adiace/sesame-robot-sense/hardware/printing/stl/Internal-Frame-v121.stl

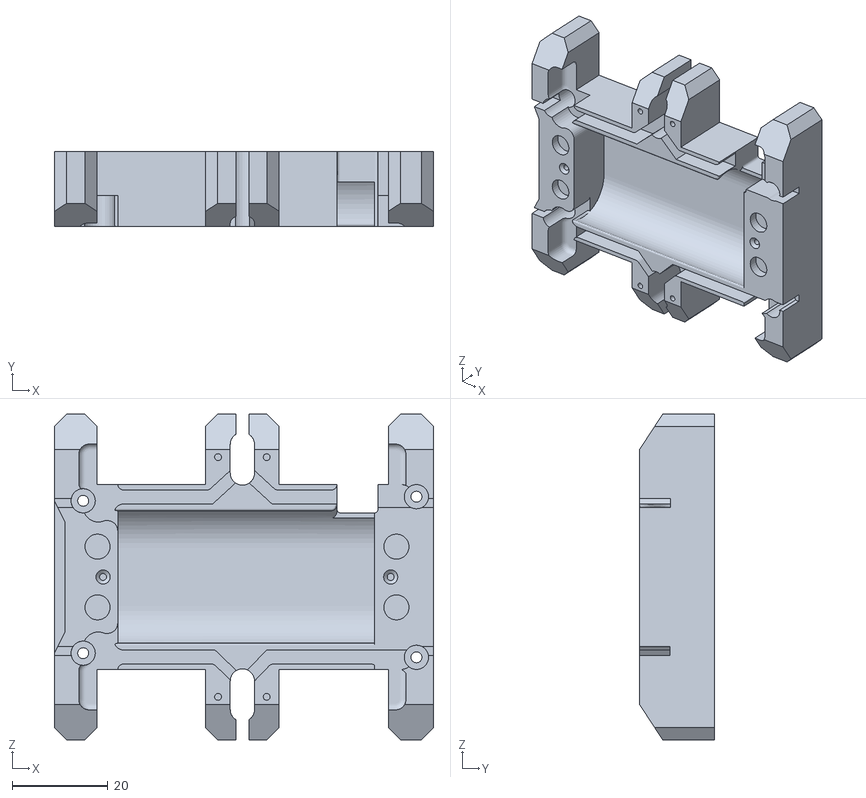
[picture p1: CAD file, 2026-05-30, last stored version]
hardware/printing/stl/Internal-Frame-v121.stl
79.2 x 15.7 x 68.1
