adiace/sesame-robot-sense/hardware/printing/stl/top-covers/hats/magnetic-modular-mount-hat.stl

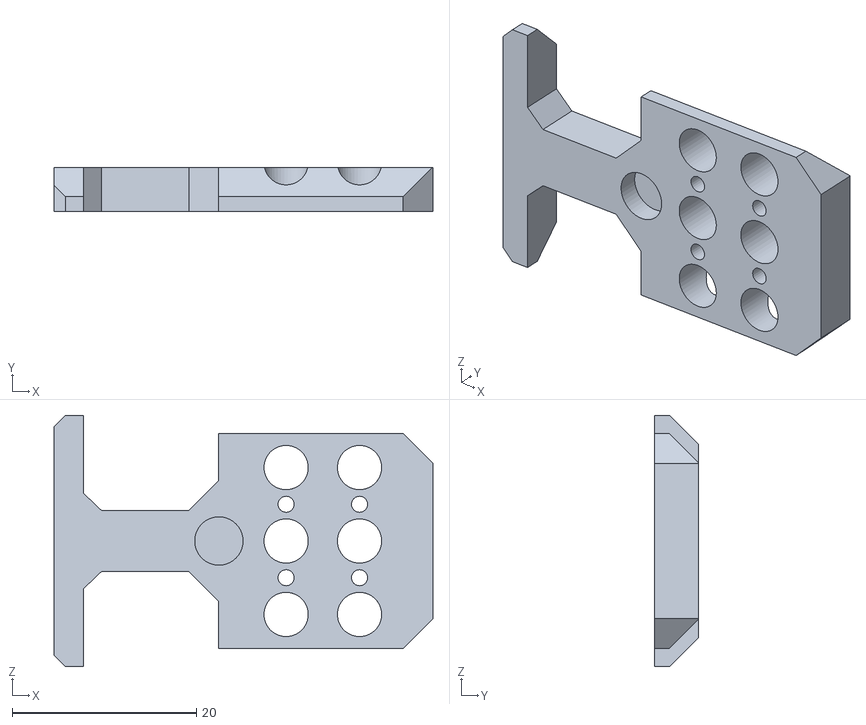
[picture p2: CAD file, 2026-01-21, last stored version]
hardware/printing/stl/top-covers/hats/magnetic-modular-mount-hat.stl
41.1 x 4.79 x 27.3
