adiace/sesame-robot-sense/hardware/printing/stl/top-covers/Top-Cover-Enclosed-v117.stl

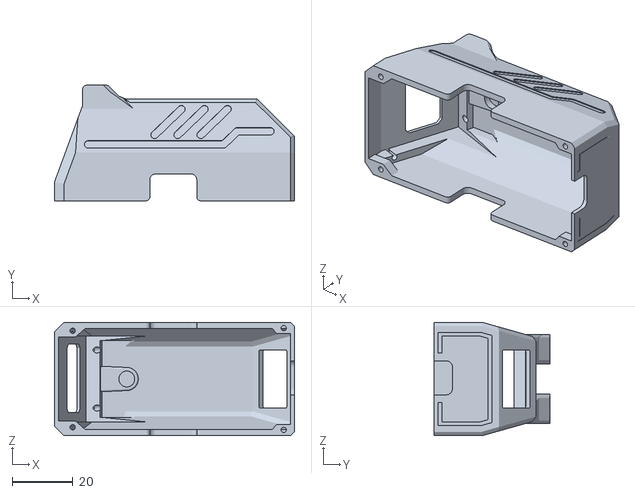
[picture p3: CAD file, 2026-03-24, last stored version]
hardware/printing/stl/top-covers/Top-Cover-Enclosed-v117.stl
79.2 x 38.2 x 37.4
