adiace/sesame-robot-sense/hardware/printing/stl/Bottom-Cover-v121.stl

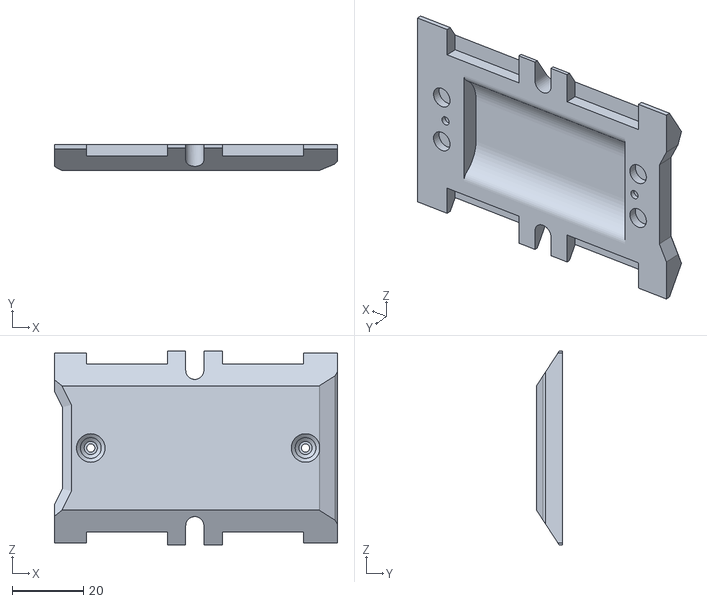
[picture p4: CAD file, 2026-05-30, last stored version]
hardware/printing/stl/Bottom-Cover-v121.stl
79.2 x 7.27 x 54.2
