adiace/sesame-robot-sense/hardware/printing/stl/top-covers/hats/magnetic-chainsaw-hat.stl

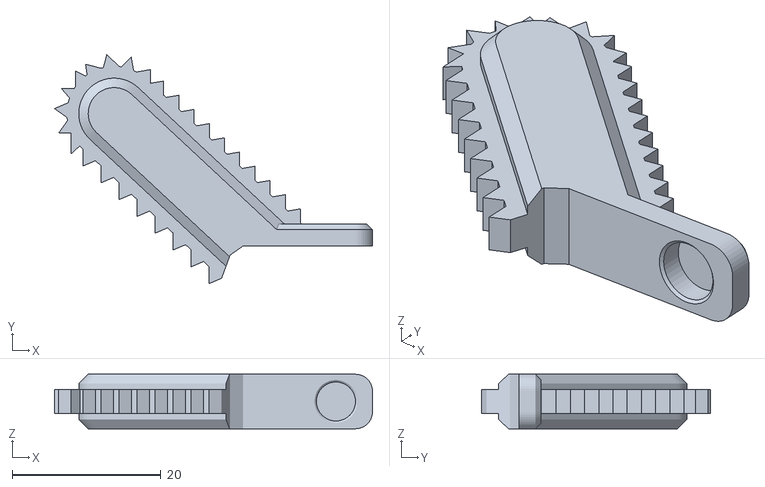
[picture p5: CAD file, 2026-01-21, last stored version]
hardware/printing/stl/top-covers/hats/magnetic-chainsaw-hat.stl
42.8 x 30.8 x 7.34
