adiace/sesame-robot-sense/hardware/printing/stl/top-covers/Top-Cover-Cat-v100.stl

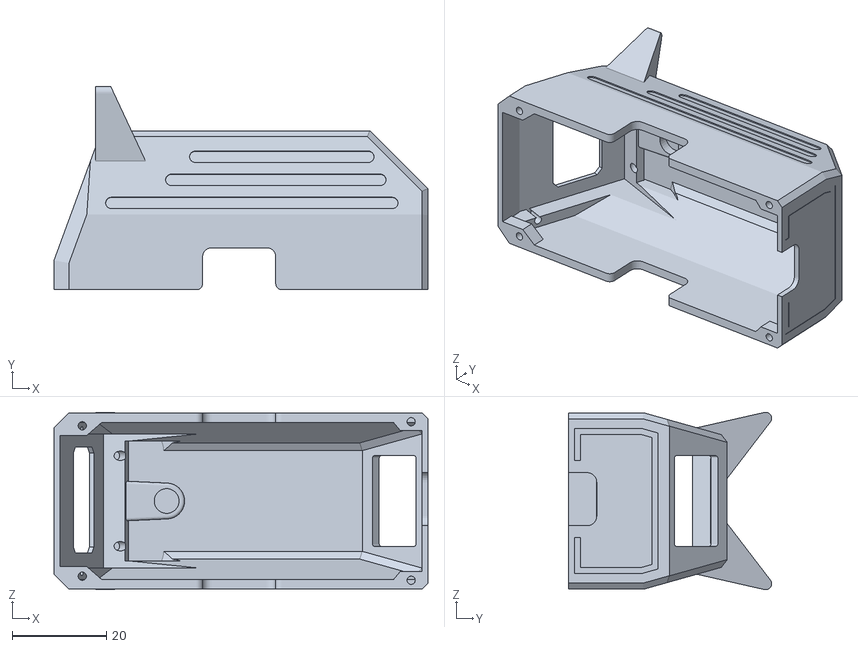
[picture p6: CAD file, 2026-02-21, last stored version]
hardware/printing/stl/top-covers/Top-Cover-Cat-v100.stl
79.2 x 43.1 x 37.6
