adiace/sesame-robot-sense/hardware/printing/stl/R1-v117.stl

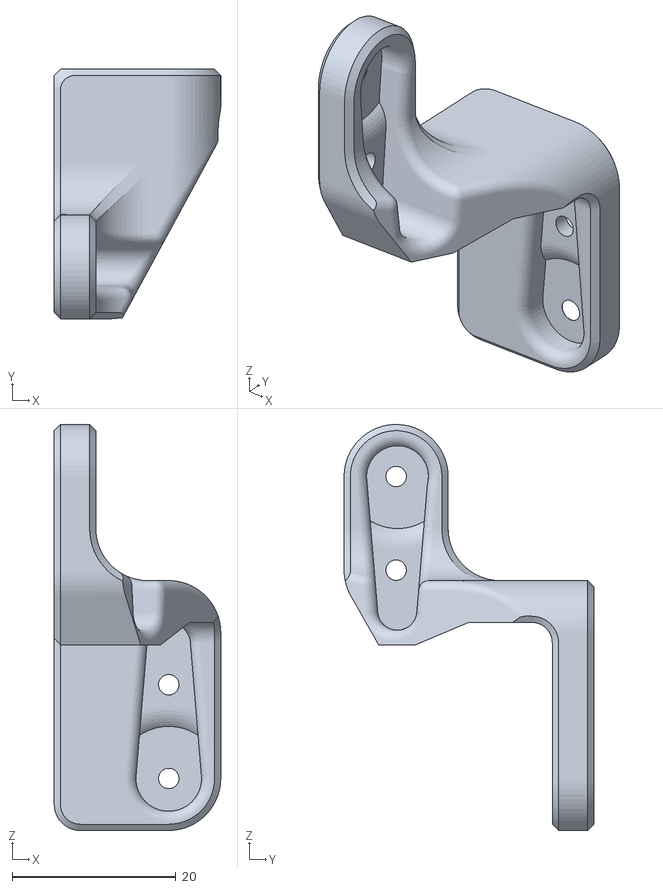
[picture p7: CAD file, 2026-03-24, last stored version]
hardware/printing/stl/R1-v117.stl
20.3 x 30.5 x 49.5
