adiace/sesame-robot-sense/hardware/printing/stl/top-covers/Top-Cover-No-Ears-v100.stl

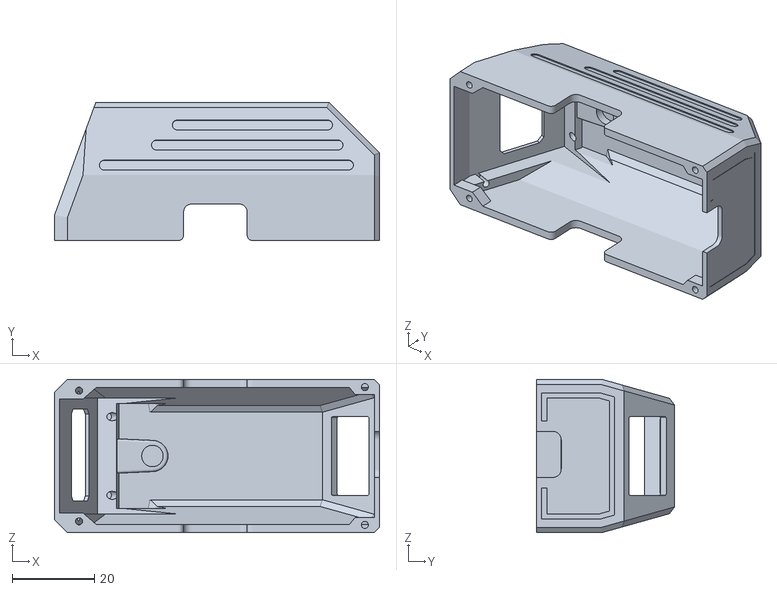
[picture p8: CAD file, 2026-02-21, last stored version]
hardware/printing/stl/top-covers/Top-Cover-No-Ears-v100.stl
79.2 x 33.7 x 37.4
