adiace/sesame-robot-sense/hardware/printing/stl/top-covers/sesame-top-cover-enclosed-v91.stl

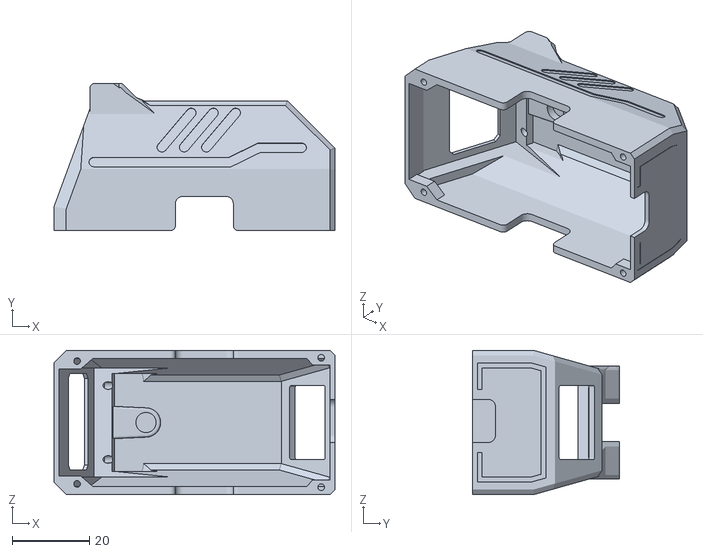
[picture p9: CAD file, 2026-02-03, last stored version]
hardware/printing/stl/top-covers/sesame-top-cover-enclosed-v91.stl
72.9 x 38.2 x 37.4
