adiace/sesame-robot-sense/hardware/printing/stl/L3-v117.stl

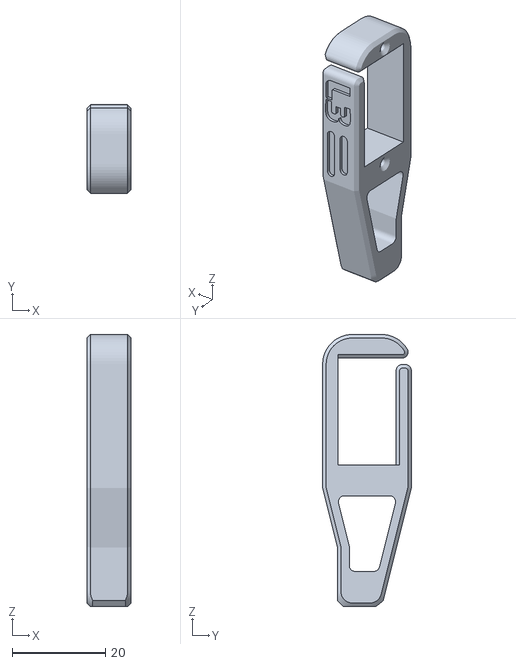
[picture p10: CAD file, 2026-03-24, last stored version]
hardware/printing/stl/L3-v117.stl
9.53 x 19.0 x 58.4
