adiace/sesame-robot-sense/hardware/printing/stl/top-covers/sesame-top-cover-enclosed-cat.stl

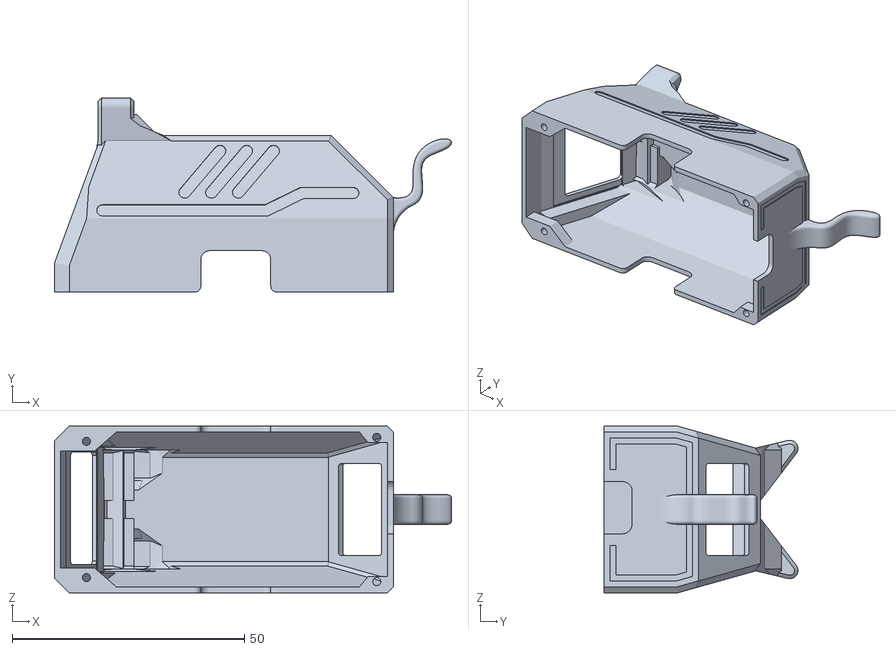
[picture p11: CAD file, 2026-01-22, last stored version]
hardware/printing/stl/top-covers/sesame-top-cover-enclosed-cat.stl
85.4 x 41.7 x 35.9
