adiace/sesame-robot-sense/hardware/printing/stl/top-covers/sesame-top-cover-original-cat.stl

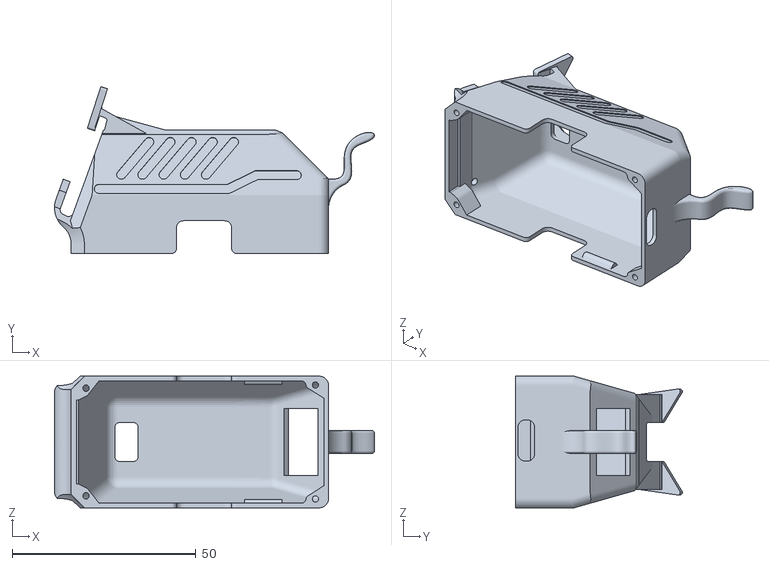
[picture p12: CAD file, 2026-01-21, last stored version]
hardware/printing/stl/top-covers/sesame-top-cover-original-cat.stl
87.1 x 45.4 x 35.9
