adiace/sesame-robot-sense/hardware/printing/stl/top-covers/sesame-top-cover-original-style.stl

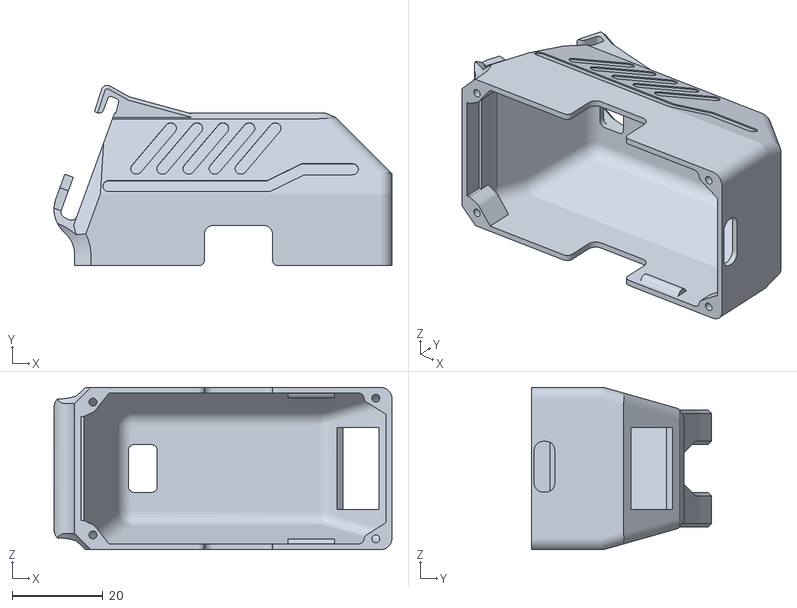
[picture p13: CAD file, 2026-01-13, last stored version]
hardware/printing/stl/top-covers/sesame-top-cover-original-style.stl
74.6 x 39.8 x 35.9
