adiace/sesame-robot-sense/hardware/printing/stl/top-covers/sesame-top-cover-enlcosed-style.stl

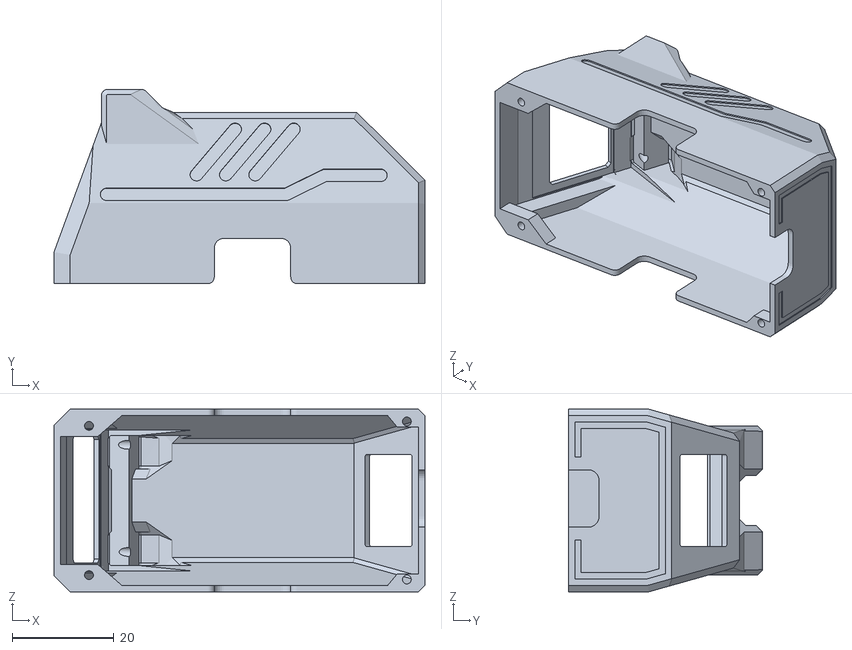
[picture p14: CAD file, 2026-01-13, last stored version]
hardware/printing/stl/top-covers/sesame-top-cover-enlcosed-style.stl
72.9 x 38.2 x 35.9
