adiace/sesame-robot-sense/hardware/printing/stl/femurjoint-R2-v100.stl

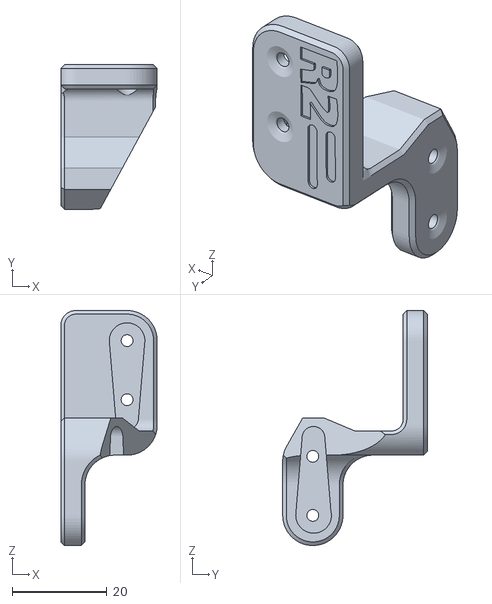
[picture p15: CAD file, 2026-02-03, last stored version]
hardware/printing/stl/femurjoint-R2-v100.stl
20.3 x 30.5 x 49.5
