adiace/sesame-robot-sense/hardware/printing/stl/foot-joint-L3-v100.stl

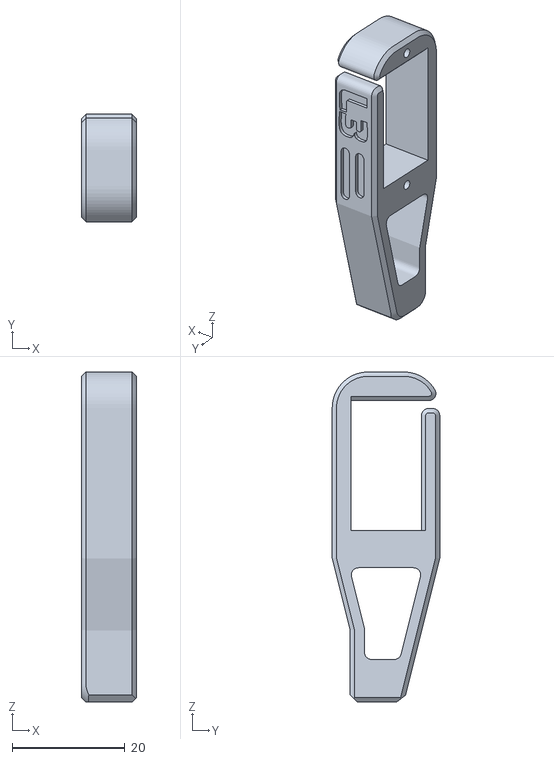
[picture p16: CAD file, 2026-02-03, last stored version]
hardware/printing/stl/foot-joint-L3-v100.stl
9.70 x 19.0 x 58.4
