adiace/sesame-robot-sense/hardware/printing/stl/Interna-Frame-v71.stl

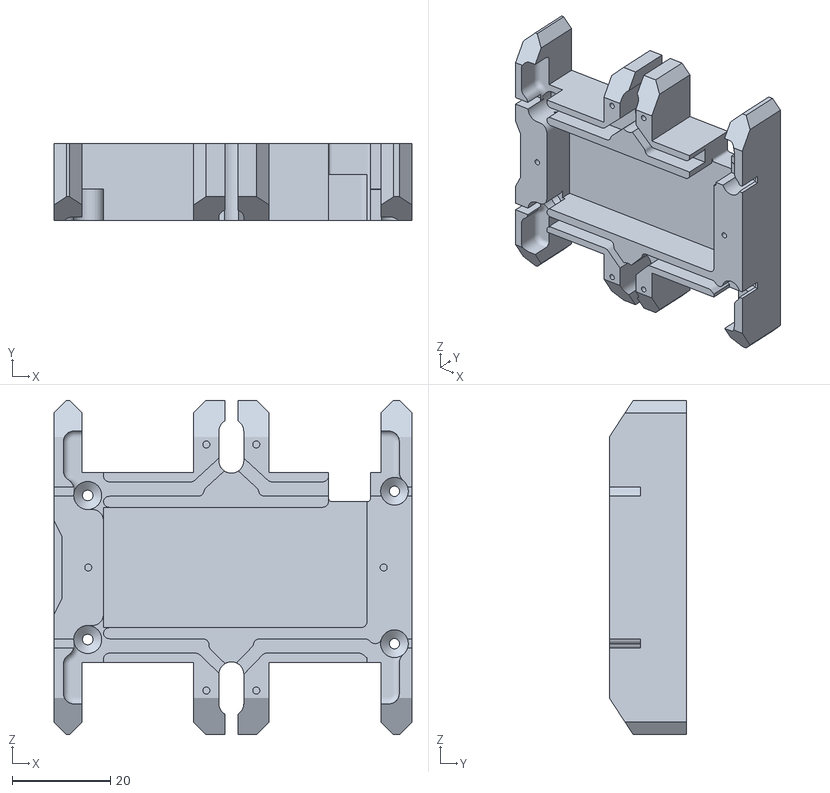
[picture p17: CAD file, 2026-01-13, last stored version]
hardware/printing/stl/Interna-Frame-v71.stl
72.9 x 15.7 x 68.1
