adiace/sesame-robot-sense/(list of files, cad)

Other CAD files:
hardware/printing/stl/R2-v117.stl
hardware/printing/stl/L1-v117.stl
hardware/printing/stl/L4-v117.stl
hardware/printing/stl/R4-v117.stl
hardware/printing/stl/L2-v117.stl
hardware/printing/stl/top-covers/sesame-top-cover-enclosed-cat-style.stl
hardware/printing/stl/R3-v117.stl
hardware/printing/stl/femurjoint-L2-v100.stl
hardware/printing/stl/foot-joint-R3-v100.stl
hardware/printing/stl/femurjoint-R1-v100.stl
hardware/printing/stl/femurjoint-L1-v100.stl
hardware/printing/stl/foot-joint-R4-v100.stl
hardware/printing/stl/foot-joint-L4-v100.stl
hardware/printing/stl/femur-joint-L1-v71.stl
hardware/printing/stl/femur-joint-R1-v71.stl
hardware/printing/stl/femur-joint-L2-v71.stl
hardware/printing/stl/Bottom-Cover-v117.stl
hardware/printing/stl/Bottom-Cover-v71.stl
hardware/printing/stl/Bottom-Cover-v80.stl
hardware/printing/stl/Internal-Frame-v117.stl
hardware/printing/stl/Internal-Frame-v80.stl
hardware/printing/stl/bottom-cover-v100.stl
hardware/printing/stl/bottom-cover-v90.stl
hardware/printing/stl/femurjoint-L1-v90.stl
hardware/printing/stl/femurjoint-L2-v90.stl
hardware/printing/stl/femurjoint-R1-v90.stl
hardware/printing/stl/femurjoint-R2--v71.stl
hardware/printing/stl/foot-joint-L3-v71.stl
hardware/printing/stl/foot-joint-L4-v71.stl
hardware/printing/stl/foot-joint-L4-v90.stl
hardware/printing/stl/foot-joint-R3-v71.stl
hardware/printing/stl/foot-joint-R3-v90.stl
hardware/printing/stl/foot-joint-R4-v71.stl
hardware/printing/stl/foot-joint-R4-v90.stl
hardware/printing/stl/internal-frame-v100.stl
hardware/printing/stl/internal-frame-v90.stl
hardware/printing/stl/top-covers/Top-Cover-Enclosed-v100.stl
hardware/printing/stl/top-covers/sesame-top-cover-enclosed-v80.stl
