adiace/sesame-robot-sense/(list of files, drawings)

Other design files:
hardware/pcb/distro-v2/SCH_Sesame-Distro-Board-V2_2026-03-06.json
hardware/pcb/distro-v3/PCB_Sesame-Distro-Board-V3.json
hardware/pcb/distro-v3/SCH_Sesame-Distro-Board-V3.json
