adiace/sesame-robot-sense/firmware/imu_handler.h

#pragma once

#include <Arduino.h>
#include <Wire.h>
#include <math.h>
#include "pins.h"
#include "wifi_log.h"

// MPU-6050 / MPU-6500 clone direct I2C driver.
// Wire.endTransmission(true) throughout — ESP32-S3 repeated-start is buggy.
// imuEmit() logs JSON to Serial and pushes to imuEventQueue for TCP streaming.

// Set 1 to enable verbose jerk / tap-rejection diagnostic logs (floods serial).
#define IMU_DEBUG 0

// ── MPU register addresses ──────────────────────────────────────────────────
#define MPU_REG_SMPLRT_DIV    0x19
#define MPU_REG_CONFIG        0x1A
#define MPU_REG_GYRO_CONFIG   0x1B
#define MPU_REG_ACCEL_CONFIG  0x1C
#define MPU_REG_FF_THR        0x1D
#define MPU_REG_FF_DUR        0x1E
#define MPU_REG_INT_ENABLE    0x38
#define MPU_REG_INT_STATUS    0x3A
#define MPU_REG_ACCEL_XOUT_H  0x3B
#define MPU_REG_PWR_MGMT_1    0x6B
#define MPU_REG_WHO_AM_I      0x75

// ── Thresholds ──────────────────────────────────────────────────────────────
// FLIPPED: raw-accel flipAngle (0° upright → 180° inverted) > 100°, 5 stable samples
#define IMU_FLIP_ANGLE_DEG    100.0f
#define IMU_FLIP_SAMPLES        5      // 5 × 20ms = 100ms

// TAPPED: 2-second peak-window detection.
// We track the max |jerk| seen across the last 100 polls (~2s at 50Hz).
// Tap fires ONLY when that peak has stayed below IMU_TAP_PEAK_MAX for the full
// 2-second window — meaning the robot has been genuinely still.  Any servo
// correction or movement spike above the threshold blocks tap for the entire
// next 2 seconds automatically, with no explicit idle-state gate needed.
// After a real tap (jerk ~60+), the tap value stays in the window for 2s,
// auto-blocking re-trigger before the 6s cooldown runs out anyway.
#define IMU_TAP_JERK           38.0f  // absolute minimum spike to qualify as a tap
#define IMU_TAP_LOCKOUT_MS    200     // inter-sample debounce (ms)
#define IMU_TAP_COOLDOWN_MS  6000     // lockout after TAPPED fires (covers wiggle + settle)
#define IMU_TAP_RATE_MAX      80.0f   // °/s — real taps ≤52; flip-back motion ≥83
#define IMU_TAP_PEAK_MAX      18.0f   // 2s window peak must be below this to allow tap
#define IMU_TAP_WIN_SIZE      100     // number of polls in window (100 × 20ms = 2s)

// PICKUP: EMA residual
// Higher alpha = EMA tracks faster = tap jolts don't inflate residual as long.
// Higher residual threshold = needs more sustained upward accel (real pickup vs tap).
#define IMU_EMA_ALPHA         0.02f
#define IMU_PICKUP_RESIDUAL   3.2f    // m/s² — must be sustained lifting motion, not a tap jolt
#define IMU_PICKUP_MS        160      // ms sustained above threshold

// FREEFALL: hardware registers (unused — hardware interrupt disabled on clones)
#define IMU_FF_THR_VAL        10
#define IMU_FF_DUR_VAL        80

// LEVEL: complementary filter < 15° sustained 3s → return to idle
#define IMU_LEVEL_ANGLE_DEG   15.0f
#define IMU_LEVEL_SUSTAIN_MS  3000

// ── Event enum ──────────────────────────────────────────────────────────────
enum ImuEvent : uint8_t {
  IMU_NONE = 0,
  IMU_PICKUP,
  IMU_FLIPPED,
  IMU_TAPPED,
  IMU_FREEFALL,
  IMU_LEVEL,
};

// ── State ───────────────────────────────────────────────────────────────────
static bool     imuReady  = false;
static ImuEvent lastEvent = IMU_NONE;
static ImuEvent imuPendingReaction = IMU_NONE;  // consumed by loop() to trigger face/move

static unsigned long imuLastPollMs = 0;

// flipAngle tracking (raw accel, 0–180°)
static float prevFlipAngle = 0.0f;
static int   flipSamples   = 0;

// Complementary filter (slow alpha, used for LEVEL only)
static float cfPitch = 0.0f;
static float cfRoll  = 0.0f;
static bool  cfSeeded = false;

// Level sustain
static unsigned long imuLevelStart = 0;

// Tap
static float         prevMag           = 9.81f;
static unsigned long tapLockoutEnd     = 0;
static float         _tapPeakBuf[IMU_TAP_WIN_SIZE] = {};
static uint8_t       _tapPeakIdx       = 0;
static uint8_t       _tapPeakFill      = 0;
static bool          tapNeedsLevel     = false;  // set on PICKUP; cleared on LEVEL
static bool          tapPending        = false;
static bool          tapPendingNoiseOk = false;  // locked at spike time; avoids re-check after spike enters buffer
static float         tapPendingMagG    = 0.0f;
static float         tapPendingP    = 0.0f;
static float         tapPendingR    = 0.0f;

// Pickup
static float         pickupEma   = 9.81f;
static unsigned long pickupStart = 0;

// Freefall (software): mag < 0.4g sustained 120ms
#define IMU_FF_MAG_THRESH  3.9f
#define IMU_FF_SUSTAIN_MS  120
static unsigned long freefallStart = 0;

// ── I2C helpers ──────────────────────────────────────────────────────────────
static bool imuWrite(uint8_t reg, uint8_t val) {
  Wire.beginTransmission(MPU6050_ADDR);
  Wire.write(reg);
  Wire.write(val);
  return Wire.endTransmission(true) == 0;
}

static bool imuReadAccel(float &ax, float &ay, float &az) {
  Wire.beginTransmission(MPU6050_ADDR);
  Wire.write(MPU_REG_ACCEL_XOUT_H);
  if (Wire.endTransmission(true) != 0) return false;
  Wire.requestFrom((uint8_t)MPU6050_ADDR, (uint8_t)14);
  if (Wire.available() < 14) return false;
  int16_t axr = ((int16_t)Wire.read() << 8) | Wire.read();
  int16_t ayr = ((int16_t)Wire.read() << 8) | Wire.read();
  int16_t azr = ((int16_t)Wire.read() << 8) | Wire.read();
  for (int i = 0; i < 8; i++) Wire.read();
  const float scale = 9.81f / 4096.0f;
  ax = axr * scale; ay = ayr * scale; az = azr * scale;
  return true;
}

static bool imuReadIntStatus(uint8_t &status) {
  Wire.beginTransmission(MPU6050_ADDR);
  Wire.write(MPU_REG_INT_STATUS);
  if (Wire.endTransmission(true) != 0) return false;
  Wire.requestFrom((uint8_t)MPU6050_ADDR, (uint8_t)1);
  if (!Wire.available()) return false;
  status = Wire.read();
  return true;
}

// ── TCP push via queue ────────────────────────────────────────────────────────
extern QueueHandle_t imuEventQueue;

static void imuEmit(ImuEvent ev, float accel = 0.0f, float pitch = 0.0f, float roll = 0.0f) {
  // TAPPED can repeat within same episode — the tapLockoutEnd already gates it.
  // All other events dedup until a different event fires (e.g. PICKUP stays PICKUP).
  if (ev == lastEvent && ev != IMU_TAPPED) return;
  lastEvent = ev;
  const char* n;
  switch (ev) {
    case IMU_PICKUP:   n = "PICKUP";   break;
    case IMU_FLIPPED:  n = "FLIPPED";  break;
    case IMU_TAPPED:   n = "TAPPED";   break;
    case IMU_FREEFALL: n = "FREEFALL"; break;
    case IMU_LEVEL:    n = "LEVEL";    break;
    default:           n = "UNKNOWN";  break;
  }
  // Reset LEVEL sustain timer so LEVEL always requires 400ms after any non-LEVEL event
  if (ev != IMU_LEVEL) imuLevelStart = 0;

  imuPendingReaction = ev;  // consumed by loop() via imuConsumeReaction()

  char json[128];
  snprintf(json, sizeof(json),
    "{\"type\":\"imu_event\",\"event\":\"%s\",\"accel\":%.2f,\"pitch\":%.1f,\"roll\":%.1f}",
    n, accel, pitch, roll);
  dlog("%s", json);                                          // Serial + WiFi log
  if (imuEventQueue) xQueueSend(imuEventQueue, json, 0);
}

static ImuEvent imuConsumeReaction() {
  ImuEvent ev = imuPendingReaction;
  imuPendingReaction = IMU_NONE;
  return ev;
}

// Reset the LEVEL sustain timer — call after a reaction so the face shows for
// the full IMU_LEVEL_SUSTAIN_MS before LEVEL can fire and return to idle.
static void imuResetLevelTimer() { imuLevelStart = millis(); }

// Suppress tap detection for ms milliseconds — call after voice pipeline ends
// to prevent speaker vibration or acoustic feedback from auto-triggering again.
static void imuSuppressTap(uint32_t ms) { tapLockoutEnd = millis() + ms; }

// ── Public API ───────────────────────────────────────────────────────────────

// I2C bus recovery: clock SCL 9 times to unstick a slave holding SDA low.
// Needed when the ESP32 is reset mid-transaction (e.g. during upload).
static void imuBusRecover() {
  pinMode(I2C_SDA, INPUT_PULLUP);
  pinMode(I2C_SCL, OUTPUT);
  for (int i = 0; i < 9; i++) {
    digitalWrite(I2C_SCL, HIGH); delayMicroseconds(5);
    digitalWrite(I2C_SCL, LOW);  delayMicroseconds(5);
  }
  // Send a STOP condition
  pinMode(I2C_SDA, OUTPUT);
  digitalWrite(I2C_SDA, LOW);
  delayMicroseconds(5);
  digitalWrite(I2C_SCL, HIGH);
  delayMicroseconds(5);
  digitalWrite(I2C_SDA, HIGH);
  delayMicroseconds(5);
  // Return pins to Wire control
  pinMode(I2C_SDA, INPUT_PULLUP);
  pinMode(I2C_SCL, INPUT_PULLUP);
  delay(10);
}

void imuSetup() {
  // Probe first; if no response, attempt bus recovery and retry once
  Wire.beginTransmission(MPU6050_ADDR);
  Wire.write(MPU_REG_WHO_AM_I);
  Wire.endTransmission(true);
  Wire.requestFrom((uint8_t)MPU6050_ADDR, (uint8_t)1);
  if (!Wire.available()) {
    Serial.println("IMU: no response — attempting I2C bus recovery");
    imuBusRecover();
    Wire.begin(I2C_SDA, I2C_SCL);
    delay(50);
    Wire.beginTransmission(MPU6050_ADDR);
    Wire.write(MPU_REG_WHO_AM_I);
    Wire.endTransmission(true);
    Wire.requestFrom((uint8_t)MPU6050_ADDR, (uint8_t)1);
  }
  if (!Wire.available()) { Serial.println("IMU: no response"); return; }
  uint8_t whoami = Wire.read();
  Serial.print("IMU: WHO_AM_I=0x"); Serial.println(whoami, HEX);

  if (!imuWrite(MPU_REG_PWR_MGMT_1, 0x01)) { Serial.println("IMU: init failed"); return; }
  delay(100);
  imuWrite(MPU_REG_SMPLRT_DIV,  0x09);
  imuWrite(MPU_REG_CONFIG,       0x03);
  imuWrite(MPU_REG_ACCEL_CONFIG, 0x10);
  imuWrite(MPU_REG_GYRO_CONFIG,  0x08);
  // Disable hardware interrupts — the freefall/motion-detect interrupt (0x80)
  // fires spuriously on MPU-6500 clones (WHO_AM_I=0x70) where bit 7 of
  // INT_STATUS is motion-detect, not freefall. We use software mag threshold.
  imuWrite(MPU_REG_INT_ENABLE, 0x00);

  pickupEma = 9.81f;
  imuReady = true;
  Serial.println("IMU: ready");
}

void imuPoll() {
  if (!imuReady) return;

  unsigned long now = millis();
  if (now - imuLastPollMs < 20) return;
  float dt = (now - imuLastPollMs) / 1000.0f;
  imuLastPollMs = now;

  float ax, ay, az;
  if (!imuReadAccel(ax, ay, az)) return;

  float mag  = sqrtf(ax*ax + ay*ay + az*az);
  float magG = mag / 9.81f;

  // ── flipAngle: atan2(horiz, az) = 0° upright, 90° sideways, 180° inverted
  // Fast raw-accel computation — no filter lag, detects inversion immediately.
  float horiz     = sqrtf(ax*ax + ay*ay);
  float flipAngle = atan2f(horiz, az) * (180.0f / M_PI);
  float flipRate  = fabsf(flipAngle - prevFlipAngle) / dt;  // °/s
  prevFlipAngle   = flipAngle;

  // ── Complementary filter for LEVEL only (slow — filters out tap jolts) ───
  float accelPitch = atan2f(-ax, sqrtf(ay*ay + az*az)) * (180.0f / M_PI);
  float accelRoll  = atan2f( ay, az)                    * (180.0f / M_PI);
  if (!cfSeeded) {
    cfPitch = accelPitch; cfRoll = accelRoll; cfSeeded = true;
  }
  const float cfAlpha = 0.85f;
  cfPitch = cfAlpha * cfPitch + (1.0f - cfAlpha) * accelPitch;
  cfRoll  = cfAlpha * cfRoll  + (1.0f - cfAlpha) * accelRoll;
  float tiltAngle = sqrtf(cfPitch*cfPitch + cfRoll*cfRoll);

  // ── Jerk + 2-second peak window ──────────────────────────────────────────
  float jerk = (mag - prevMag) / dt;
  prevMag = mag;

  // 2-second peak window. History peak is read BEFORE the current sample is stored —
  // adding first would let the tap spike block its own detection.
  float tapPeak2s = 0.0f;
  for (uint8_t _i = 0; _i < IMU_TAP_WIN_SIZE; _i++)
    if (_tapPeakBuf[_i] > tapPeak2s) tapPeak2s = _tapPeakBuf[_i];
  bool noiseOk = (_tapPeakFill >= IMU_TAP_WIN_SIZE) && (tapPeak2s < IMU_TAP_PEAK_MAX);
  // Now store current sample (ages into history for future polls)
  float _absjerk = fabsf(jerk);
  _tapPeakBuf[_tapPeakIdx] = _absjerk;
  _tapPeakIdx = (_tapPeakIdx + 1) % IMU_TAP_WIN_SIZE;
  if (_tapPeakFill < IMU_TAP_WIN_SIZE) _tapPeakFill++;
  const float tapThresh = IMU_TAP_JERK;

  // ── EMA residual ─────────────────────────────────────────────────────────
  pickupEma = pickupEma * (1.0f - IMU_EMA_ALPHA) + mag * IMU_EMA_ALPHA;
  float pickupResidual = mag - pickupEma;  // positive only: pickup = upward accel (mag > EMA)

  // ── FREEFALL (software threshold — hardware interrupt unreliable on clones) ─
  if (mag < IMU_FF_MAG_THRESH) {
    if (freefallStart == 0) freefallStart = now;
    if (now - freefallStart >= IMU_FF_SUSTAIN_MS) {
      imuEmit(IMU_FREEFALL, magG, cfPitch, cfRoll);
      freefallStart = 0;
      goto check_level;
    }
  } else {
    freefallStart = 0;
  }

  // ── FLIPPED: flipAngle > 100°, 5 consecutive stable samples ─────────────
  if (flipAngle > IMU_FLIP_ANGLE_DEG) {
    if (++flipSamples >= IMU_FLIP_SAMPLES)
      imuEmit(IMU_FLIPPED, magG, cfPitch, cfRoll);
    tapPending = false;                    // jerk at flip-start is not a tap
    tapLockoutEnd = now + 500;
    goto check_level;  // suppress TAPPED/PICKUP while inverted
  } else {
    flipSamples = 0;
  }

  // ── TAPPED (jerk detection — runs BEFORE pickup so tap jolt isn't eaten) ──
  // Deferred confirmation: jerk spike → tapPending; next poll checks residual.
  // Running jerk check first prevents the pickup block from setting tapLockoutEnd
  // on the same poll as the jerk spike (which previously blocked tap for 1.5s).
  if (tapPending) {
    tapPending = false;
    bool tiltOk = (fabsf(cfPitch) < 25.0f && fabsf(cfRoll) < 25.0f);
    bool confirmOk = tapPendingNoiseOk;  // use locked value — history now includes tap spike
#if IMU_DEBUG
    dlog("IMU: tap confirm jerk=%.1f peak2s=%.1f thresh=%.1f residual=%.2f needsLevel=%d noiseOk=%d",
         jerk, tapPeak2s, tapThresh, pickupResidual, (int)tapNeedsLevel, (int)confirmOk);
#endif
    if (!tapNeedsLevel && tiltOk && confirmOk
        && fabsf(pickupResidual) < 0.5f && flipRate < IMU_TAP_RATE_MAX) {
      imuEmit(IMU_TAPPED, tapPendingMagG, tapPendingP, tapPendingR);
      tapLockoutEnd = now + IMU_TAP_COOLDOWN_MS;
      tapNeedsLevel = true;
      goto check_level;
    }
#if IMU_DEBUG
    if (!confirmOk)
      dlog("IMU: tap rejected (peak2s was %.1f >= %.1f or window not full — not quiet yet)", tapPeak2s, (float)IMU_TAP_PEAK_MAX);
    else if (tapNeedsLevel)
      dlog("IMU: tap rejected (waiting for LEVEL after pickup/tap)");
    else if (!tiltOk)
      dlog("IMU: tap rejected (tilt p=%.1f r=%.1f)", cfPitch, cfRoll);
    else
      dlog("IMU: tap rejected (|residual|=%.2f flipRate=%.0f)", fabsf(pickupResidual), flipRate);
#endif
  }
#if IMU_DEBUG
  // Diagnostic: log every qualifying jerk so we can tune thresholds
  if (fabsf(jerk) > 15.0f && now > tapLockoutEnd)
    dlog("IMU: jerk=%.1f peak2s=%.1f thresh=%.1f %s",
         jerk, tapPeak2s, tapThresh,
         (jerk > tapThresh && noiseOk) ? "*** TAP PENDING ***" : "(blocked)");
#endif

  if (jerk > tapThresh && noiseOk && flipRate < IMU_TAP_RATE_MAX && now > tapLockoutEnd) {
    tapLockoutEnd        = now + IMU_TAP_LOCKOUT_MS;
    tapPending           = true;
    tapPendingNoiseOk    = noiseOk;  // lock: history was quiet at detection moment
    tapPendingMagG       = magG;
    tapPendingP          = cfPitch;
    tapPendingR          = cfRoll;
    goto check_level;
  }
  // ── PICKUP ───────────────────────────────────────────────────────────────
  if (pickupResidual > IMU_PICKUP_RESIDUAL) {
    if (pickupStart == 0) pickupStart = now;
    if (now - pickupStart >= IMU_PICKUP_MS) {
      pickupEma = mag;
      imuEmit(IMU_PICKUP, magG, cfPitch, cfRoll);
      tapNeedsLevel = true;  // require LEVEL before next tap (blocks set-down jolt)
      tapLockoutEnd = now + 1500;
    }
    goto check_level;
  } else {
    pickupStart = 0;
  }

check_level:
  if (lastEvent != IMU_NONE && lastEvent != IMU_LEVEL) {
    if (tiltAngle < IMU_LEVEL_ANGLE_DEG) {
      if (imuLevelStart == 0) imuLevelStart = now;
      if (now - imuLevelStart >= IMU_LEVEL_SUSTAIN_MS) {
        imuEmit(IMU_LEVEL, magG, cfPitch, cfRoll);
        tapNeedsLevel = false;  // robot is settled — tap allowed again
      }
    } else {
      imuLevelStart = 0;
    }
  }
}
