adiace/sesame-robot-sense/(commit log)

2025-12-02 Revise README for ESP32-based Sesame project
    Updated project description and hardware requirements to reflect the use of ESP32 and PCA9685. Revised features and added a warning about the repository's construction status.
2026-01-07 Add beta firmware and assets
    Added initial firmware source files for Sesame Robot, including S2 Mini and Distro Board variants, face bitmap assets (faces.json), and placeholder assets. Updated README with detailed technical documentation, hardware abstraction, and asset pipeline instructions.
2026-01-07 Add wiring guide documentation and assets
    Introduces a new wiring-guide section with detailed instructions for wiring the Sesame Robot, including guides for S2 Mini and Distro Board setups. Adds related images and updates the main README to reference the new wiring guide.
2026-01-07 Add Sesame Studio animation tool
    Introduces Sesame Studio, a Python-based GUI for composing robot animations and generating C++ code for the Sesame Robot. Includes documentation and initial implementation with servo input, frame sequencing, code generation, and help overlay.
2026-01-08 Revamp README with badges and improved build instructions
    Added project badges for license, microcontroller, firmware, IDE, and GitHub stats. Reorganized and clarified build instructions, including step-by-step getting started guide, links to BOM, printing, build, and wiring guides. Introduced sections for Sesame Studio and firmware, and improved overall readability and structure.
2026-01-08 Add README files for PCB, BOM, and 3D printing guides
    Added initial README.md files for hardware/PCB and hardware/printing directories, providing overviews for schematics and 3D printing instructions. Expanded hardware/bom/README.md with rough component list, power requirements, and guidance on choosing between PCB and proto-board versions.
2026-01-08 Add sesame motor tester firmware for ESP32
    Introduces a new Arduino sketch for testing and calibrating up to 8 servo motors using ESP32. Supports serial commands to move individual or all motors to a specified angle, and to power down all motors.
2026-01-08 [WIP] Add comprehensive Sesame Robot build guide with images
    Expanded the build guide in docs/build-guide/README.md to include detailed step-by-step assembly instructions, wiring, calibration, and final checks for the Sesame Robot. Added numerous illustrative images to docs/build-guide/assets/ to support the guide. Moved sesame-angle-guide.png to the assets directory. Removed the obsolete datasheets README.
2026-01-08 Fix formatting and link in README files
    Restores missing horizontal rule in the main README and corrects the relative path for the wiring guide link in the build guide README.
2026-01-09 Revise hardware README with detailed build guide
    Expanded the hardware/README.md to include a directory guide, build path options, step-by-step getting started instructions, and links to supporting documents. This update clarifies the hardware stack, assembly process, and available resources for both protoboard and custom PCB builds.
2026-01-09 Update 3D printing guide
    Expanded the README to include a support requirements table for each component, specific print settings, and visual guides for manual support placement and joint orientation. This provides clearer instructions for optimal 3D printing results.
2026-01-09 Add Sesame Distro Board PCB files
    Added Gerber archive, schematic, and layout images for the Sesame Distro Board. Updated README with board details, sponsor info, and ordering instructions for PCB fabrication.
2026-01-09 Add printing asset images for hardware
    Added four new PNG images to hardware/printing/assets: joints-orientation, sliced-topcover, topcover-supports1, and topcover-supports2. These assets are likely used for documentation or visualization of hardware printing processes.
2026-01-09 Update CAD README
    Expanded the README to clarify available CAD formats, provide guidance for editing with free tools, and add tips for remixing and maintaining design files. Also redirected users seeking STL files to the printing directory.
2026-01-09 Revamp BOM documentation
    Expanded and reorganized the Bill of Materials README to provide detailed tables for all required components, wiring options, power sources, connectors, fasteners, 3D printed parts, and recommended tools. Added Amazon search links for representative parts and clarified build strategies and safety notes for both PCB and hand-wired versions.
2026-01-09 Revamp build guide
    Expanded the Sesame Robot build guide with a clear phased workflow, detailed checklists, and step-by-step instructions for each assembly stage. Added tables, tips, warnings, and troubleshooting advice to improve clarity and reduce common errors. The guide now covers parts gathering, wiring, hardware pre-assembly, main assembly, calibration, and final firmware flashing, making the build process more organized and beginner-friendly.
2026-01-09 Expand wiring guide
    Added a section describing two wiring strategies (S2 Mini/hand wiring and Sesame Distro Board/ESP32-DevKitC-32E) to help users choose based on their needs. Included references to wiring diagrams for both methods and clarified instructions. Replaced PCBway sponsorship details with a link to the hardware documentation for more information.
2026-01-13 Update hardware and wiring docs with improved images and links
    Replaced markdown image syntax with HTML <img> tags for better control over image display in wiring and PCB guides. Updated BOM PCB link to reference local documentation. Revised printing guide to include STL file links and note multiple top cover styles. Minor grammar and formatting improvements throughout hardware documentation.
2026-01-13 Add v71 STL files for frame, joints, and covers
    Introduces new 3D printable STL files for version 71, including bottom cover, internal frame, femur and foot joints, and multiple top cover styles. These files support updated hardware designs for printing and assembly.
    [Bottom-Cover-v71.stl, Interna-Frame-v71.stl, femur-joint-L1-v71.stl, femur-joint-L2-v71.stl, femur-joint-R1-v71.stl, femurjoint-R2--v71.stl, foot-joint-L3-v71.stl, foot-joint-L4-v71.stl]
2026-01-13 Add PCB image and update servo comment
    Added pcbs.png to hardware/pcb directory. Updated a comment in the firmware to clarify servo pulse width mapping.
2026-01-13 Added CAD version 73 Files
    Added f3z archive and step archive files for base sesame full design.
2026-01-13 Add launch video embed to README
    Inserted a YouTube iframe to showcase the launch video, providing users with a visual introduction to the project.
2026-01-13 Update PCB README
    Added a VSCode launch.json for CMake debugging and updated the hardware/PCB/README.md with minor formatting changes and improved instructions for ordering the Sesame Distro Board.
2026-01-13 Delete hardware/PCB directory
    Weird incorrect directory
2026-01-13 Fixed pcb README file
2026-01-15 Fix little typo in PCB README to render image
    "L" should be "l" to match the name of the image file.
2026-01-17 Fix False Pin Number on S2 Mini Guide
    https://github.com/dorianborian/sesame-robot/issues/4#issue-3823691873
2026-01-18 Revamp forward and reverse walk cycle + Bitmaps
    Replaced placeholder face bitmap arrays with actual 128x64px bitmap data for various face expressions in sesame-firmware-S2-mini.ino. Also updated comments for I2C and servo pin definitions to be more generic for the S2 Mini board.
    Revamped walk cycle for consistency, fixed reverse walk cycle for going backwards.
2026-01-21 Update README with Sesame Distro Board V1 Information
    Added caution note about the Sesame Distro Board V1 issues and recommended S2 Mini approach until V2 is released.
2026-01-21 Update README with note for distro board V1
    Added caution note regarding issues with V1 of the Sesame distro board and recommended alternatives until V2 is released.
2026-01-21 Document 2× 10440 Li-ion + AAA holder battery option
    Updated build, wiring, and BOM documentation to include details and recommendations for using 2× 10440 Li-ion cells in a 2× AAA holder as a battery option. Added notes on fit, wiring, charging, and sourcing to guide users considering this alternative.
    https://github.com/dorianborian/sesame-robot/issues/3
2026-01-21 Update build guide for top cover styles and add images
    Expanded the build guide to cover both Enclosed and Original top cover assembly steps, including wiring and installation instructions. Added new images for display wiring, display insertion, securing the display, and switch installation. Corrected screw specification for securing the bottom cover.
2026-01-21 Update CAD source files to V81
2026-01-21 Add and update STL files for top cover styles and hats
    Added new STL files for magnetic hats and various top cover styles, including enclosed and cat variants. Updated file names for consistency and removed obsolete files. Added a README describing each top cover style.
    [magnetic-chainsaw-hat.stl, magnetic-modular-mount-hat.stl, sesame-top-cover-enclosed-cat.stl, sesame-top-cover-enclosed-v80.stl, sesame-top-cover-enlcosed-style.stl, sesame-top-cover-original-cat.stl, sesame-top-cover-original-v71.stl]
2026-01-21 Update affected STL files to v80
    [Bottom-Cover-v71.stl, Bottom-Cover-v80.stl, Interna-Frame-v71.stl, Internal-Frame-v80.stl]
2026-01-21 Update STL links in documentation
2026-01-22 Refactor firmware to modular structure and add headers (+animations)
    Reorganized firmware into a modular structure with new header files for face bitmaps, movement sequences, and captive portal web assets. Updated README to document the new architecture and asset pipeline. Removed obsolete JSON asset files and the old Distro Board firmware. Introduced a macro-based system for face asset management and animation, improving extensibility and maintainability.
2026-01-22 Add Correct Top cover file for enclosed cat
    https://github.com/dorianborian/sesame-robot/issues/12
    [sesame-top-cover-enclosed-cat.stl]
2026-01-23 Update README with detailed pin configuration tables
    Expanded the documentation to include explicit pin mapping tables for both the Lolin S2 Mini (ESP32-S2) and Sesame Distro Board (ESP32-WROOM32). This provides clearer guidance for hardware setup and eases porting to other ESP32 variants.
    https://github.com/dorianborian/sesame-robot/issues/14
2026-01-23 Add detailed firmware flashing instructions to README
    Expanded the README with step-by-step instructions for flashing the firmware, including prerequisites, board setup, configuration, upload process, and troubleshooting tips.
2026-02-03 Update joints to v90
    Updated all joints to design version 90. Debossed text and details are now significantly larger to improve print tolerance. Resolves Issue #20
    [femur-joint-L1-v71.stl, femur-joint-L2-v71.stl, femur-joint-R1-v71.stl, femurjoint-L1-v90.stl, femurjoint-L2-v90.stl, femurjoint-R1-v90.stl, femurjoint-R2--v71.stl, femurjoint-R2-v90.stl]
2026-02-03 Update CAD source files to v91
    Major improvements to overall printability of the design, clearance, and various other issues. Main changes:
    Increased wall thickness on top cover for printing and structural support. #16
    Increased font size for debossed details on all joints to account for issue #20
    Relocated mounting holes for the top cover to improve Distro Board V1 and V2 clearance (V2 coming soon)
    Cleaned up the internal mounting of the OLED display for the enclosed top cover.
2026-02-03 Update misc stl to v90
    [Internal-Frame-v80.stl, bottom-cover-v90.stl, internal-frame-v90.stl]
2026-02-03 Update Enclosed top cover to v91
    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
    [sesame-top-cover-enclosed-v80.stl, sesame-top-cover-enclosed-v91.stl]
2026-02-03 Update STL links to v90 in printing README
    Bump referenced STL files in hardware/printing/README.md to the v90 revisions and normalize several filenames. Updated entries for Joint R1-R4, Joint L1-L4, Internal Frame, and Bottom Cover to point to the new v90 STL files; Top Cover entry unchanged. This keeps the README in sync with the latest printed-part releases and naming conventions.
2026-02-03 Update top cover README version to v91
    Rename the top cover section header in hardware/printing/stl/top-covers/README.md from "Enclosed v80" to "Enclosed v91" to reflect the current modern Sesame top cover version and keep documentation consistent.
2026-02-03 Add WiFi info scrolling and input tracking
    Introduce a scrolling WiFi info banner on the OLED and track user input to hide it once interaction begins. Adds state variables (lastInputTime, firstInputReceived, showingWifiInfo, wifiScrollPos, wifiInfoText), recordInput() to mark activity, and updateWifiInfoScroll() to display a scrolling WiFi/PSK message after 30s idle (scrolls every 150ms, 2px per step) while preserving the current face bitmap as background. Call recordInput() from web command handlers (pose/go/stop and a new motor=value handler) and from serial command parsing; call updateWifiInfoScroll() from loop(). Also initialize wifiInfoText and input tracking in setup(), and change star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
2026-02-03 Revamp captive portal UI and controls
    Overhauled the captive-portal HTML/CSS/JS to modernize the UI and add features: updated page title and responsive layout, new visual theme vars and polished button/section styles, and a desktop-friendly column layout. Added a command queue (max 3) with status indicator and queue management to throttle commands, plus motor locking during animations. Introduced a Manual Motor Control panel with 8 sliders and lock indicator, expanded Settings with grouped sections, motor speed and debugMode options, and theme color selection (persisted to localStorage). Gamepad support and polling were implemented with button/axis bindings and UI connection state. Adjusted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
2026-02-03 Add per-servo subtrim and CLI commands #17
    Introduce servoSubtrim[8] to store per-servo angle offsets and apply them in setServoAngle (angle+subtrim is constrained to 0–180). Add serial CLI commands and aliases: 'subtrim'/'st' to list values, 'subtrim save'/'st save' to print an initializer for copying into code, 'subtrim reset'/'st reset' to zero all trims, and 'subtrim <motor> <value>'/'st <motor> <value>' to set an individual motor's trim (validated to -90..+90). These changes make it easier to fine-tune servo neutral positions at runtime. Closes Issue #17
2026-02-03 Update serial banner to Motor Tester Interface
    Change the printed header in firmware/debugging-firmware/sesame-motor-tester.ino
2026-02-04 Update docs to improve clarity and consistency
    Revise documentation across guides and hardware README files to recommend the Lolin S2 Mini for new builds and clarify usage of the Sesame Distro Board V1. Add explicit notes that Distro Board V1 cannot run on tethered USB-C power, requires an ESP32 DevKit without pre-soldered headers, and that battery power must use a buck converter. Standardize fastener specs (many M2→M2.5 and M2×5 mm screw updates), adjust BOM items (rocker switch model, buck/current spec, connector pitches), and improve wiring/assembly instructions (servo labels S0–S7, updated distro board wording, calibration tips, and references to sesame-firmware-main.ino and the deb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
2026-02-04 Update Build Guide Photos
    Fix screw dimensions to normalized M2x5mm
2026-02-07 fix: typo in rocker power switch model number
    I believe the rocker switches are KCD1s
2026-02-07 Name aliases for servos, useable in webapi and enforced in Studio
2026-02-15 Organize PCB files and add distro-v2 artifacts
    Move existing V1 PCB assets into hardware/pcb/distro-v1 (Gerber_Sesame-Distro-Board_PCB_Sesame-Distro-Board_V1.zip and Schematic_Sesame-Distro-Board.png) and add V2 manufacturing files under hardware/pcb/distro-v2: BOM_Sesame-Distro-V2.csv, Gerber_Sesame-Distro-V2_PCB.zip, and PickAndPlace_PCB_Sesame-Distro-V2.csv. This separates v1 and v2 PCB artifacts for clearer versioned packaging and production workflows.
    [BOM_Sesame-Distro-V2.csv, PickAndPlace_PCB_Sesame-Distro-V2.csv]
2026-02-15 Add Distro Board V2 docs and clarify build options
    Introduce and document the Sesame Distro Board V2 across the repo and clarify build paths. Updates to README files (root, docs, firmware, hardware, bom, and pcb) add V2 as the current option (pre-flashed in Build Kits), mark V1 as legacy, clarify power and pin behavior (V2 supports USB-C PD; V1 requires battery + buck), and provide assembly/ordering guidance and file locations for V2. Minor wording tweaks also change phrasing from “recommended for new builds” to “DIY” and generalize references to Distro Board headers/pin selection in firmware.
2026-02-15 Add 1000 µF electrolytic capacitor to BOM #33
    Add a 1000 µF electrolytic capacitor entry to hardware/bom/README.md. The capacitor is recommended to smooth the buck converter output (10V+ rating advised) and is included with a reference link for procurement. This helps reduce voltage ripple on the distro board power supply. #33
2026-02-18 Fix compile error due to missing change in last PR
    [movement-sequences.h]
2026-02-18 Removed debug print not cleaned up in last PR
2026-02-19 fix(bom): make link destination explicit and rename column to Source
2026-02-21 Update all hardware to v100
    Update source hardware files, links and all stl print files to v100 revision.
    v100 hardware changes:
    Overall frame length has been increased by 0.25in to account for V2 distro board and wire sizing. Top cover ear revs have been migrated and updated. Various other changes including hole positioning and clearence. (may need polish via v101)
    [Top-Cover-Cat-v100.stl, Top-Cover-Enclosed-v100.stl, Top-Cover-No-Ears-v100.stl, bottom-cover-v100.stl, bottom-cover-v90.stl, femurjoint-L1-v100.stl, femurjoint-L1-v90.stl, femurjoint-L2-v100.stl]
2026-03-07 PCB BOM Part number and item specification
    Fixed part number and item specification mentioned in issues #42 #43 #44
    [BOM_Sesame-Distro-V2.csv]
2026-03-07 Added easyEDA Json File
    addresses issue #35
    [SCH_Sesame-Distro-Board-V2_2026-03-06.json]
2026-03-13 Add PSRAM detection and heap control
    Detect and manage PSRAM usage and add optional heap control. Conditionally include esp_heap_caps.h and define HAS_EXTMEM_HEAP_CONTROL. Introduce FORCE_DISABLE_PSRAM_HEAP (default true) to hard-disable PSRAM-backed heap by default to avoid instability. Add PSRAM status variables, refreshPsramStatus() and configurePsram() to detect PSRAM, print diagnostics, and enable/disable extmem heap (using heap_caps_malloc_extmem_enable when available). Expose PSRAM fields in the status API response and call configurePsram() from setup(). Also rename access-point SSID from "Sesame-Controller-BETA" to "Sesame-Controller".
2026-03-24 Update Hardware to V117
    Hardware update v117!
    Fixed issue where M2.5x5mm screws don't reach the servo motor shaft when inserted into hip joint.
    Fixed servo horns pressing into hip joints at a weird angle, adding small lifted area to account for uneven servo horn shape.
    Improved tolerences and fitment.
    Updated bottom plate to accept M2x5mm. All screws now use M2x5mm and should fit.
    [Bottom-Cover-v117.stl, Internal-Frame-v117.stl, L1-v117.stl, L2-v117.stl, L3-v117.stl, L4-v117.stl, R1-v117.stl, R2-v117.stl]
2026-03-25 Add tutorial button to README
    Added a tutorial button and updated the greeting.
2026-03-25 Add tutorial button to build guide README
    Added a tutorial button image link to the build guide.
2026-03-27 Distro-v2 BOM fix
    [BOM_Sesame-Distro-V2.csv]
2026-03-29 Revise build guide content and add assets
    Rewrite and reorganize the build-guide README: add a tutorial video link, clarify Phase 3 pre-assembly (rename femur->hip and foot->leg), update top-cover soldering and OLED/power-switch instructions, and expand Phase 4 motor installation and calibration steps (including special handling for Distro Board V2). Update checklists and final wiring/top-cover procedures. Add new image assets (battery connector, display soldering, V2 board, wire routing, zip-tie bundles), rename servo image, and remove an outdated done image.
2026-03-29 Fix duplicate Tutorial button
2026-03-30 Firmware README: add ESP32-S3 & troubleshooting
    Clarify board selection and per-board settings: split Sesame Distro V1/V2 into ESP32 Dev Module and ESP32S3 Dev Module, and reorganize the "Configure board settings" section with Lolin S2 Mini and Distro V2 (ESP32-S3) specific options (USB CDC, Flash Mode, Partition Scheme, upload speed). Improve troubleshooting: add Linux USB permission instructions (dialout group), note that USB CDC On Boot is required for S3 boards to appear after reset, and suggest trying a custom AP password if devices can't connect. Minor wording and formatting adjustments to make setup steps clearer.
2026-04-02 Update README.md to include warning for ESPServo
    Addresses issue #53 to specify esp32servo library version.
2026-04-19 Adjust button sizes in README.md
2026-04-19 Adjust button size and alignment in README
2026-04-19 Replace S2 Mini wiring diagram with new image
    Swap the old S2 Mini wiring diagram for an updated image (s2-mini-wiring-guide-new.png) and remove the previous PNG. Update the wiring-guide README to reference the new diagram, add credit to the contributor (@captianeverypowersr), and apply minor formatting/whitespace cleanups throughout the document.
2026-04-29 Refactor L2 movement from 60 to 90 in 2 pose functions
    Line 97 and 148: changed L2 angle from 60 to 90 degrees (minimum). L2 range of movement stated as 90-180. L2 at 60 resulted in the L2 hip joint contacting the cover when in place, damaging the servo.
    [movement-sequences.h]
2026-05-05 Update servo description in BOM README
2026-05-13 docs: reformat firmware README and update pin tables
    Clean up and reformat firmware/README.md: fix Markdown spacing and note blocks, escape ampersand in TOC, normalize blank lines, and standardize code blocks and lists. Convert and standardize pin mappings into Markdown tables and split Sesame Distro Board V1/V2 entries (add V2/ESP32-S3 pin mapping). Improve flashing/network instructions and examples (network mode snippets, AP notes), and make small whitespace/formatting fixes in embedded Python/JS snippets. Documentation-only changes; no functional firmware code was modified.
2026-05-30 Update printed parts to v121
    Replace Internal-Frame-v117 with Internal-Frame-v121 and rename Bottom-Cover to Bottom-Cover-v121. Update README: add battery upgrade note about Bambu Lab 14500 Li-ion compatibility, update the STL table to reference v121 files and improve formatting, and fix minor whitespace/formatting in the docs.
    [Bottom-Cover-v117.stl, Bottom-Cover-v121.stl, Internal-Frame-v117.stl, Internal-Frame-v121.stl]
2026-05-30 Add Distro Board V3 files and update docs
    Add full Sesame Distro Board V3 PCB design and assets and update documentation to reflect V3 as the current board. New files: distro-v3 BOM, Gerbers, PCB JSON, Pick-and-Place, schematic PNG and board images. Updated top-level README, hardware/README, and hardware/bom/README to document V3 features (ESP32-S3 mention, USB-C PD 12V notes, Bambu Lab 14500 battery option), clarify V2/V1 legacy status, and provide ordering/assembly instructions for V3. Small editorial cleanup and power/safety clarifications included.
    This update adresses and solves issues:
    #63 #56 #62
    [BOM_Sesame-Distro-Board-V3.csv, PCB_Sesame-Distro-Board-V3.json, PickAndPlace_PCB_Sesame-Distro-Board-V3.csv, SCH_Sesame-Distro-Board-V3.json]
2026-05-30 Update CAD files to v122
2026-05-30 Docs: update build, wiring and firmware READMEs
    Rework and clarify project documentation across three READMEs. The build guide was reformatted and polished (phase table, checklists, and walkthrough steps) and updated power/cell recommendations. The wiring guide now documents the Distro Board V3 (and V2/V1 distinctions), tightens battery/connector and buck converter guidance, and updates recommended cell types and safety notes. The firmware README was refreshed with clearer flashing steps, board selection guidance, and library recommendations (ESP32Servo v3.0.9) along with other tooling/troubleshooting clarifications. Minor wording, layout, and safety improvements throughout.
2026-06-27 Phase 1+2: IMU events over TCP via FreeRTOS queue
    - imu_handler.h: Phase 1 detection logic (cfAlpha=0.85, shake var=0.40g², tap jerk=60)
    with Phase 2 changes only: JSON emit, imuEventQueue push, LEVEL-after-FLIP fix,
    tiltRate tap guard for flip-back false positives
    - firmware.ino: imuEventQueue (Core1→Core0), drained in serviceTcpClient()
    - robot_link.py: DTR=False open, persistent TCP readline buffer
    - imu_receiver.py: TCP/serial IMU event listener
    [firmware.ino, imu_handler.h, pins.h]
2026-06-27 Phase 2 done: IMU events (PICKUP, FLIP, TAPPED, LEVEL) over TCP
    Events pushed as JSON via FreeRTOS queue — Core 1 detects, Core 0 sends
    over the existing TCP connection on port 8888. SHAKEN removed after proving
    impossible to discriminate reliably from repeated taps on this hardware.
    Key fixes from Phase 1 baseline:
    - flipAngle = atan2(horiz, az) for true 0-180° inversion detection
    - goto check_level after every event so LEVEL always fires on return
    - PICKUP uses positive-only EMA residual (mag > EMA) to avoid false
    triggers when setting down; imuEmit resets LEVEL timer so LEVEL
    always requires a fresh 400ms after any event
    - Wire.begin(I2C_SDA, I2C_SCL) explicit pins required on cur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
    [firmware.ino, imu_handler.h]
2026-06-28 Add Phase 5a voice assistant and XIAO ESP32-S3 port
    Ports Sesame from the original ESP32-S2 Mini to the XIAO ESP32-S3 Sense
    on the techiesms AI Pin PCB, replacing direct GPIO servo drive with a
    PCA9685 I2C PWM driver. Adds a full tap-triggered voice assistant pipeline.
    Hardware changes:
    - PCA9685 I2C servo driver replaces ESP32Servo direct GPIO
    - MPU-6050 IMU on shared I2C bus (clone chip, direct register access)
    - MAX98357A I2S speaker amp (IDF 5.x new channel API)
    - PDM microphone on I2S_NUM_0 (shared with speaker, swap on record)
    - SDA moved to GPIO8 to avoid I2S LRC conflict on GPIO5
    Voice assistant (Phase 5a):
    - Trigger: IMU tap detection
    - Record: VAD-gated PDM mic, time-based silenc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
    [BOM_Sesame-Distro-Board-V3.csv, BOM_Sesame-Distro-V2.csv, Bottom-Cover-v121.stl, Internal-Frame-v121.stl, L1-v117.stl, L2-v117.stl, L3-v117.stl, L4-v117.stl]
2026-06-30 Add PCA9685 motor tester with bring-up calibration
    Standalone sketch for servo bring-up on XIAO ESP32-S3 + PCA9685.
    Replaces the original ESP32Servo-based tester which used direct GPIO.
    Key findings from physical bring-up:
    - MG90S safe pulse range is 500-2400us (SERVOMIN=102, SERVOMAX=491 at
    50Hz/25MHz), not the 732-2929us the original Sesame used. The wider
    range stalls servos and strips gears.
    - Per-channel angle limits baked in to prevent mechanical damage.
    - Non-blocking sweep using millis() timing.
    - PCA9685 channels 3 and 8 showed intermittent signal — root cause was
    wrong pulse width causing servo hunting, not faulty hardware.
    Calibrated values for this build (trim centers,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
    [firmware.ino, motor_tester.ino]
2026-06-30 Port bring-up calibration to main firmware
    Updates firmware with values determined during motor_tester bring-up:
    Pulse range: SERVOMIN=102/SERVOMAX=491 (500-2400us at 50Hz/25MHz).
    Replaces original 150/600 (732-2929us) which exceeded MG90S physical
    limits and caused stall/gear damage. Remove setOscillatorFrequency()
    call — use PCA9685 default 25MHz oscillator.
    servoSubtrim: {-5, 2, 8, -4, -5, 2, 0, 4} (R1 R2 L1 L2 R4 R3 L3 L4)
    servoRev: R2/L1/R3/L4 = true (mirror-mounted, opposite direction)
    Movement sequences will need re-tuning for the new pulse range.
    Claude-Session: https://claude.ai/code/session_01BYgZBw8HHHf6XEPrZ7A1Gq
    [firmware.ino, pins.h]
2026-06-30 Fix servo calibration: servoRev=false, update stand pose
    servoRev correction: all servos are false. Mirror-mounted left-side
    servos are handled by mirrored angles in movement sequences (original
    Sesame approach), not firmware reversal flags. Setting rev=true would
    have inverted all existing sequence angles.
    Stand pose updated for 500-2400µs pulse range + servoSubtrim offsets.
    Logical angles derived from motor_tester bring-up values using:
    logical = tester_raw - subtrim
    R1=125 R2=53 L1=47 L2=124 R4=50 R3=133 L3=45 L4=131
    Rest pose (all,90) already correct via servoSubtrim — no change needed.
    Gait/trick sequences retain original angles and will need physical
    re-tuning; they won't produ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
    [firmware.ino, movement-sequences.h]
2026-06-30 Move WiFi credentials to gitignored wifi_credentials.h
    Replaces hardcoded placeholder SSID/password in firmware.ino with an
    #include of wifi_credentials.h, which is gitignored. Prevents
    credentials from being accidentally committed.
    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
    [firmware.ino]
2026-06-30 Fix OLED blank and tap over-sensitivity
    OLED: move display.begin() before audioSetup()/micSetup() so I2S init
    can't affect I2C bus state. Add Wire.setClock(400000) and serial
    confirmation so boot log shows whether OLED init succeeded.
    Tap: raise IMU_TAP_JERK from 28 → 55 (table vibrations reach 30-35,
    finger taps typically 60-200). Tighten residual gate from < 1.0 → < 0.5
    (table vibrations confirmed at 0.84, finger taps settle faster).
    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
    [firmware.ino, imu_handler.h]
2026-06-30 Swap PDM mic CLK/DATA pins — RMS was saturating at 30935
    MIC_PDM_CLK 42→41, MIC_PDM_DATA 41→42. Constant max-amplitude RMS
    indicates data pin was floating or receiving clock signal instead of
    PDM data. Try swapped config; revert if mic goes silent.
    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
    [mic_handler.h]
2026-06-30 Fix serial stop not working mid-movement
    Extract serial parser into drainSerial() helper and call it from
    pressingCheck(). Previously, loop() was blocked inside walk/pose
    sequences and serial bytes sat unread in the buffer until the pose
    finished. Now stop/halt/freeze sent via serial interrupt the movement
    immediately, same as TCP/HTTP.
    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
    [firmware.ino]
2026-06-30 Fix gait knee angles for 500-2400µs pulse range
    Original gait used 0°/45° for R4/L3 knees and 135°/180° for R3/L4.
    With new pulse range (500-2400µs) and our servo mounting:
    - R4/L3 increase with angle (higher = lift, lower = plant)
    - R3/L4 decrease with angle (lower = lift, higher = plant)
    - 0° and 180° extremes hit mechanical stops
    Knee constants defined from bring-up calibration:
    R4: plant=50, lift=110 (physical 45°/105°)
    R3: plant=133, lift=75 (physical 135°/77°)
    L3: plant=45, lift=110 (physical 45°/110°)
    L4: plant=131, lift=75 (physical 135°/79°)
    Applied to walk forward, walk backward, turn left, turn right.
    Hip angles unchanged — they work with subtrim ap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
    [movement-sequences.h]
2026-06-30 Fix drainSerial static/extern linkage conflict
    [firmware.ino]
2026-06-30 Revert gait to original angles, fix only R4 plant
    Previous gait rewrite had the knee directions wrong. The original
    Sesame angles were correct:
    - R4=0: lift (low pulse = retracted). R4=45: plant (too low, not enough extension).
    - R3=135/180: plant range (high angle = extended down). Correct.
    - L3=45: plant, L3=0: maximum plant/extension (low angle = more down). Correct.
    - L4=135: plant, L4=180: maximum extension. Correct.
    Only real fix needed: R4 plant angle 45→140 so right front knee extends
    as far down as the other three knees during the walk cycle.
    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
    [movement-sequences.h]
2026-06-30 Raise R4 lift angle 0→30 to avoid mechanical stop
    [movement-sequences.h]
2026-06-30 Fix R4 direction: high=lift, low=plant in walk/backward
    [movement-sequences.h]
2026-06-30 Restore original Sesame pulse range; recalculate subtrim for our horn positions
    SERVOMIN 102→150, SERVOMAX 491→600 (732-2929µs — matches original ESP32Servo range).
    servoSubtrim recalculated so setServoAngle(i,90) still hits each servo's physical
    center: values range -24 to -35 (horns were attached at ~1400µs in 500-2400µs system,
    now corrected to 732-2929µs system). With these subtrims logical 180° maps to ~2500µs,
    within MG90S physical range. All gait/stand/rest angles reverted to original Sesame
    values — no re-tuning needed since range now matches what they were designed for.
    Claude-Session: https://claude.ai/code/se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
    [firmware.ino, movement-sequences.h, pins.h]
2026-06-30 Reset servoSubtrim to zero — let original 732-2929µs angles run full range
    [firmware.ino]
2026-06-30 Fix knee range and hip direction: SERVOMIN=102, servoRev R2+L1
    SERVOMIN 150→102 (732→500µs): front knees R4/L3 need 500µs to reach full
    extension; they were stopping halfway at 732µs. SERVOMAX stays 600 (2929µs)
    for rear knees R3/L4.
    servoRev[R2]=true, servoRev[L1]=true: these two hips are mounted in the
    opposite rotational direction from what the original Sesame gait expects.
    Without reversal they swing inward into the body. With reversal setServoAngle
    (R2,45)→physical 135° (outward). R2=100→80 in two poses to avoid the 80°
    body-clearance limit.
    Claude-Session: https://claude.ai/code/session_01BYgZBw8HHHf6XEPrZ7A1Gq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
    [firmware.ino, movement-sequences.h, pins.h]
2026-06-30 Revert servoRev R2/L1 — those hips were already correct
    [firmware.ino, movement-sequences.h]
2026-06-30 SERVOMAX 600→491: stop servo stalling past physical limit
    2929µs (600 ticks) is 529µs past the MG90S 2400µs physical stop.
    Rear knees at R3/L4=180° were stalling and heating up. 491 ticks = 2400µs
    = the actual physical maximum. Front knees at 0° = 500µs already correct.
    [pins.h]
2026-06-30 Stagger PCA9685 PWM phase per channel to eliminate current-surge jerk
    Each channel's pulse starts 512 ticks later than the previous (ch0=0,
    ch1=512, ..., ch7=3584). Peak current from 8 servos no longer coincides,
    eliminating the voltage sag that caused delayed/jerky movement on stand/rest.
    [firmware.ino]
2026-06-30 Bake in calibrated servoSubtrim from physical bring-up
    Values from 'dump' after stand/rest trim: {-7, 5, 11, -2, -7, 2, 2, 3}
    R1 R2 L1 L2 R4 R3 L3 L4
2026-06-30 Set motorCurrentDelay=0: PWM phase stagger replaces software delay
    20ms per servo * 8 servos = 160ms lag on every pose change. The PCA9685
    phase stagger (ch * 512 ticks offset) distributes current peaks in hardware,
    making the software inter-servo delay unnecessary.
    [firmware.ino]
2026-07-01 Phase 5b: on-device voice, audio PSRAM playback, tap peak window, box pose
    Key changes:
    - imu_handler.h: replace EMA tap with 2-second peak window (100-sample ring buffer);
    peak checked from history before storing current sample so tap spike can't self-block;
    tapPendingNoiseOk locked at detection time so confirmation poll isn't fooled by spike
    - audio_handler.h: add playWavFromMemory() — plays WAV directly from PSRAM buffer
    without SPIFFS write; stopAudio() frees PSRAM buffer when done
    - voice_handler.h: receive WAV response into ps_malloc buffer; call playWavFromMemory()
    so long TTS responses (>128KB) play correctly; no SPIFFS capacity limit
    - movement-sequences.h: add box pose (c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
    [partitions.csv]
2026-07-01 README: remove Albert-protocol reference; add companion app section with diff table
    - Replace "Albert-protocol TCP" and "Albert-compatible" wording — there's no such
    protocol, the TCP stack just happened to share a vocabulary with an older project
    - Add Companion App section with link to sesame-companion-app-sense and a table
    comparing it to the original sesame-companion-app (local LLM, robot voice pipeline,
    TCP transport, raw command bypass, LLM hardening)
    - Update Key Features: expand sensor bullet into separate IMU/Audio/Wake Word/Camera
    sections now that those are fully implemented
    - Fix docs table: remove deleted software/README.md link
    - Fix Credits: replace Albert-protocol m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
2026-07-02 Phase 6A: add sleep/wake commands for motor protection
    PCA9685 sleep/wake commands in applyCommandLine(): rest pose → pwm.sleep()
    cuts oscillator and unpowers all servo outputs; wake restores stand pose.
    Prevents servo wear during idle periods.
    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
    [firmware.ino]
2026-07-02 docs: add sleep/wake commands and motor protection section
    docs/commands.md: new Power/idle section with sleep and wake entries.
    README.md: motor protection feature in key features; updated companion app
    diff table with idle timer, persistent memory, and kids content rows.
    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
2026-07-02 tweak: raise box pose height (knees 47° → 30° bend)
    Reduces knee flex from 47° to 30° from stand position so the boxing
    stance is taller — raised guard look rather than a deep crouch.
    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
    [movement-sequences.h]
2026-07-02 tweak: box pose knees 30° → 40° (just a hair taller than original 47°)
    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
2026-07-02 tweak: box pose knees 40° → 35°
    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
2026-07-02 fix: gate IMU jerk/tap-reject diagnostics behind IMU_DEBUG flag
    Jerk logs (>15 m/s²) and tap confirm/reject traces fired on every robot
    movement, flooding the serial monitor and TCP log port. Wrapped in
    #if IMU_DEBUG 0 so they compile away by default. Set IMU_DEBUG 1 to
    re-enable during threshold tuning.
    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
    [imu_handler.h]
2026-07-02 fix: sleep command — leg slump and wrong face
    delay 500→1000ms: gives loaded MG90S servos enough time to reach rest
    position (90°) before pwm.sleep() cuts the oscillator. At 500ms a slow
    servo was still mid-travel and fell to a random position when unpowered.
    exitIdle() before setFace("sleepy"): idleActive was still true after
    runRestPose(), so updateIdleBlink() in loop() kept overriding the face
    back to idle every few seconds.
    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
    [firmware.ino]
